jeroentaverne/tnCartWonder/rtl/src/board/wondertang_rev200b/wondertang_board_rev200b_clock.sv

//
// wondertang_board_rev200b_clock.sv
//
// BSD 3-Clause License
//
// Copyright (c) 2024, Albert Herranz
//
// based on board_rev1_clock.sv
// Copyright (c) 2024, Shinobu Hashimoto
//
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
// 3. Neither the name of the copyright holder nor the names of its
//    contributors may be used to endorse or promote products derived from
//    this software without specific prior written permission.
//
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

`default_nettype none

/***********************************************************************
 *
 ***********************************************************************/
module WONDERTANG_BOARD_REV200B_CLOCK (
    input wire      RESET_n,
    input wire      CLK_IN,
    input wire      CLK_27M,

    output wire     CLK_BASE,
    output wire     CLK_21M,
    output wire     CLK_DAC,
    output wire     CLK_BASE_READY,

    output wire     CLK_MEM,
    output wire     CLK_MEM_P,
    output wire     CLK_MEM_READY,

    output wire     CLK_TMDS_S,
    output wire     CLK_TMDS_P,
    output wire     CLK_TMDS_READY
);
    /***************************************************************
     * 基本クロック
     ***************************************************************/
    assign CLK_BASE = CLK_MEM;
    assign CLK_BASE_READY = CLK_MEM_READY;

    /***************************************************************
     * 107.4MHz * 44 / 35 = 134.25MHz
     ***************************************************************/
    assign CLK_TMDS_READY = RESET_n && lock_135m;
    wire lock_135m;
    rPLL u_pll_tmds (
        .CLKOUT(CLK_TMDS_S),
        .LOCK(lock_135m),
        .CLKOUTP(),
        .CLKOUTD(),
        .CLKOUTD3(),
        .RESET(!CLK_MEM_READY),
        .RESET_P(1'b0),
        .CLKIN(CLK_MEM),
        .CLKFB(1'b0),
        .FBDSEL({1'b0,1'b0,1'b0,1'b0,1'b0,1'b0}),
        .IDSEL({1'b0,1'b0,1'b0,1'b0,1'b0,1'b0}),
        .ODSEL({1'b0,1'b0,1'b0,1'b0,1'b0,1'b0}),
        .PSDA({1'b0,1'b0,1'b0,1'b0}),
        .DUTYDA({1'b0,1'b0,1'b0,1'b0}),
        .FDLY({1'b0,1'b0,1'b0,1'b0})
    );

    defparam u_pll_tmds.FCLKIN = "107.4";
    defparam u_pll_tmds.DYN_IDIV_SEL = "false";
    defparam u_pll_tmds.IDIV_SEL = 3;
    defparam u_pll_tmds.DYN_FBDIV_SEL = "false";
    defparam u_pll_tmds.FBDIV_SEL = 4;
    defparam u_pll_tmds.DYN_ODIV_SEL = "false";
    defparam u_pll_tmds.ODIV_SEL = 4;
    defparam u_pll_tmds.PSDA_SEL = "0000";
    defparam u_pll_tmds.DYN_DA_EN = "true";
    defparam u_pll_tmds.DUTYDA_SEL = "1000";
    defparam u_pll_tmds.CLKOUT_FT_DIR = 1'b1;
    defparam u_pll_tmds.CLKOUTP_FT_DIR = 1'b1;
    defparam u_pll_tmds.CLKOUT_DLY_STEP = 0;
    defparam u_pll_tmds.CLKOUTP_DLY_STEP = 0;
    defparam u_pll_tmds.CLKFB_SEL = "internal";
    defparam u_pll_tmds.CLKOUT_BYPASS = "false";
    defparam u_pll_tmds.CLKOUTP_BYPASS = "false";
    defparam u_pll_tmds.CLKOUTD_BYPASS = "false";
    defparam u_pll_tmds.DYN_SDIV_SEL = 2;
    defparam u_pll_tmds.CLKOUTD_SRC = "CLKOUT";
    defparam u_pll_tmds.CLKOUTD3_SRC = "CLKOUT";
    defparam u_pll_tmds.DEVICE = "GW2AR-18C";

    /***************************************************************
     * 134.25MHz /5 = 26.85MHz
     ***************************************************************/
    CLKDIV u_div_tmds (
        .CLKOUT(CLK_TMDS_P),
        .HCLKIN(CLK_TMDS_S),
        .RESETN(CLK_TMDS_READY),
        .CALIB(1'b0)
    );
    defparam u_div_tmds.DIV_MODE = "5";
    defparam u_div_tmds.GSREN = "false";

`ifdef XXX_TEMP_FIX_MUST_BE_FIXED_IN_A_PROPER_WAY_WONT_PASS_TIMING_REPORT_AND_MAY_CAUSE_INSTABILITIES
    /***************************************************************
     * 3.58MHz * 30 = 107.4MHz
     ***************************************************************/
    wire CLK_MEM_LOCK;
    assign CLK_MEM_READY = RESET_n && CLK_MEM_LOCK;
    rPLL u_pll_base (
        .CLKOUT(CLK_MEM),
        .LOCK(CLK_MEM_LOCK),
        .CLKOUTP(CLK_MEM_P),
        .CLKOUTD(),
        .CLKOUTD3(),
        .RESET(!RESET_n),
        .RESET_P(1'b0),
        .CLKIN(CLK_IN),
        .CLKFB(1'b0),
        .FBDSEL({1'b0,1'b0,1'b0,1'b0,1'b0,1'b0}),
        .IDSEL({1'b0,1'b0,1'b0,1'b0,1'b0,1'b0}),
        .ODSEL({1'b0,1'b0,1'b0,1'b0,1'b0,1'b0}),
        .PSDA({1'b0,1'b0,1'b0,1'b0}),
        .DUTYDA({1'b0,1'b0,1'b0,1'b0}),
        .FDLY({1'b1,1'b1,1'b1,1'b1})
    );

    defparam u_pll_base.FCLKIN = "3.58";
    defparam u_pll_base.DYN_IDIV_SEL = "false";
    defparam u_pll_base.IDIV_SEL = 0;
    defparam u_pll_base.DYN_FBDIV_SEL = "false";
    defparam u_pll_base.FBDIV_SEL = 29;
    defparam u_pll_base.DYN_ODIV_SEL = "false";
    defparam u_pll_base.ODIV_SEL = 8;
    defparam u_pll_base.PSDA_SEL = "1000";
    defparam u_pll_base.DYN_DA_EN = "false";
    defparam u_pll_base.DUTYDA_SEL = "1000";
    defparam u_pll_base.CLKOUT_FT_DIR = 1'b1;
    defparam u_pll_base.CLKOUTP_FT_DIR = 1'b1;
    defparam u_pll_base.CLKOUT_DLY_STEP = 0;
    defparam u_pll_base.CLKOUTP_DLY_STEP = 0;
    defparam u_pll_base.CLKFB_SEL = "internal";
    defparam u_pll_base.CLKOUT_BYPASS = "false";
    defparam u_pll_base.CLKOUTP_BYPASS = "false";
    defparam u_pll_base.CLKOUTD_BYPASS = "false";
    defparam u_pll_base.DYN_SDIV_SEL = 2;
    defparam u_pll_base.CLKOUTD_SRC = "CLKOUT";
    defparam u_pll_base.CLKOUTD3_SRC = "CLKOUT";
    defparam u_pll_base.DEVICE = "GW2AR-18C";
`else
    wire CLK_MEM_LOCK;
    assign CLK_MEM_READY = RESET_n && CLK_MEM_LOCK;
    localparam FREQ=108_000;
    rPLL u_pll_base (
        .CLKOUT(CLK_MEM),
        .LOCK(CLK_MEM_LOCK),
        .CLKOUTP(CLK_MEM_P),
        .CLKOUTD(),
        .CLKOUTD3(),
        .RESET(!RESET_n),
        .RESET_P(1'b0),
        .CLKIN(CLK_27M),
        .CLKFB(1'b0),
        .FBDSEL(6'b000000),
        .IDSEL(6'b000000),
        .ODSEL(6'b000000),
        .PSDA(4'b0000),
        .DUTYDA(4'b0000),
        .FDLY(4'b1111)
    );
    defparam u_pll_base.FCLKIN = "27";
    defparam u_pll_base.DYN_IDIV_SEL = "false";
    defparam u_pll_base.IDIV_SEL = 0;
    defparam u_pll_base.DYN_FBDIV_SEL = "false";
    defparam u_pll_base.FBDIV_SEL = 3;
    defparam u_pll_base.DYN_ODIV_SEL = "false";
    defparam u_pll_base.ODIV_SEL = 8;
    defparam u_pll_base.PSDA_SEL = "1000";
    defparam u_pll_base.DYN_DA_EN = "false";
    defparam u_pll_base.DUTYDA_SEL = "1000";
    defparam u_pll_base.CLKOUT_FT_DIR = 1'b1;
    defparam u_pll_base.CLKOUTP_FT_DIR = 1'b1;
    defparam u_pll_base.CLKOUT_DLY_STEP = 0;
    defparam u_pll_base.CLKOUTP_DLY_STEP = 0;
    defparam u_pll_base.CLKFB_SEL = "internal";
    defparam u_pll_base.CLKOUT_BYPASS = "false";
    defparam u_pll_base.CLKOUTP_BYPASS = "false";
    defparam u_pll_base.CLKOUTD_BYPASS = "false";
    defparam u_pll_base.DYN_SDIV_SEL = 2;
    defparam u_pll_base.CLKOUTD_SRC = "CLKOUT";
    defparam u_pll_base.CLKOUTD3_SRC = "CLKOUT";
    defparam u_pll_base.DEVICE = "GW2AR-18C";
`endif

    /***************************************************************
     * 107.4MHz / 5 = 21.48MHz
     ***************************************************************/
    CLKDIV u_div_21m (
        .CLKOUT(CLK_21M),
        .HCLKIN(CLK_BASE),
        .RESETN(CLK_BASE_READY),
        .CALIB(1'b0)
    );
    defparam u_div_21m.DIV_MODE = "5";
    defparam u_div_21m.GSREN = "false";

    /***************************************************************
     * 27MHz / 5 = 5.4MHz
     ***************************************************************/
    wire CLK_5_4M;
    CLKDIV u_div_5p4m (
        .CLKOUT(CLK_5_4M),
        .HCLKIN(CLK_27M),
        .RESETN(RESET_n),
        .CALIB(1'b0)
    );
    defparam u_div_5p4m.DIV_MODE = "5";
    defparam u_div_5p4m.GSREN = "false";

    /***************************************************************
     * 5.4MHz / 3.5 = 1542KHz ~ 48KHz * 32 = 1536KHz
     ***************************************************************/
    CLKDIV u_div_dac (
        .CLKOUT(CLK_DAC),
        .HCLKIN(CLK_5_4M),
        .RESETN(RESET_n),
        .CALIB(1'b0)
    );
    defparam u_div_dac.DIV_MODE = "3.5";
    defparam u_div_dac.GSREN = "false";

endmodule

`default_nettype wire
