jeroentaverne/tnCartWonder/(commit log)

2024-09-14 Add workarounds for board stability, publish bitstreams.
    [ws2812.v]
2024-09-18 temp fix for dreaded bootloop
    [config.sv, wondertang_board_rev200b_clock.sv]
2024-09-22 extend bootloop temp fix to V1.02d and V1.01c boards
    [board_rev1_clock.sv, config.sv, tnCart_board_rev1_top.sv]
2024-10-22 rev2: fix signal mux state machine
    The signal mux has now 12 states in board rev2 but only 9 can be reached
    because the state counter is not updated correctly.
    [board_rev2_bus.sv]
2024-10-27 Modify MUX operation timing to compensate for rev2 circuit delay.
    [tnCart_rev2.kicad_sch]
2024-11-03 modify rev2 schematic
    [tnCart_rev2.kicad_sch]
